poommyroboticcamera-netizen/ESC-FOC-Driver-V3.0/docs/assets/schematic-power-stage.png

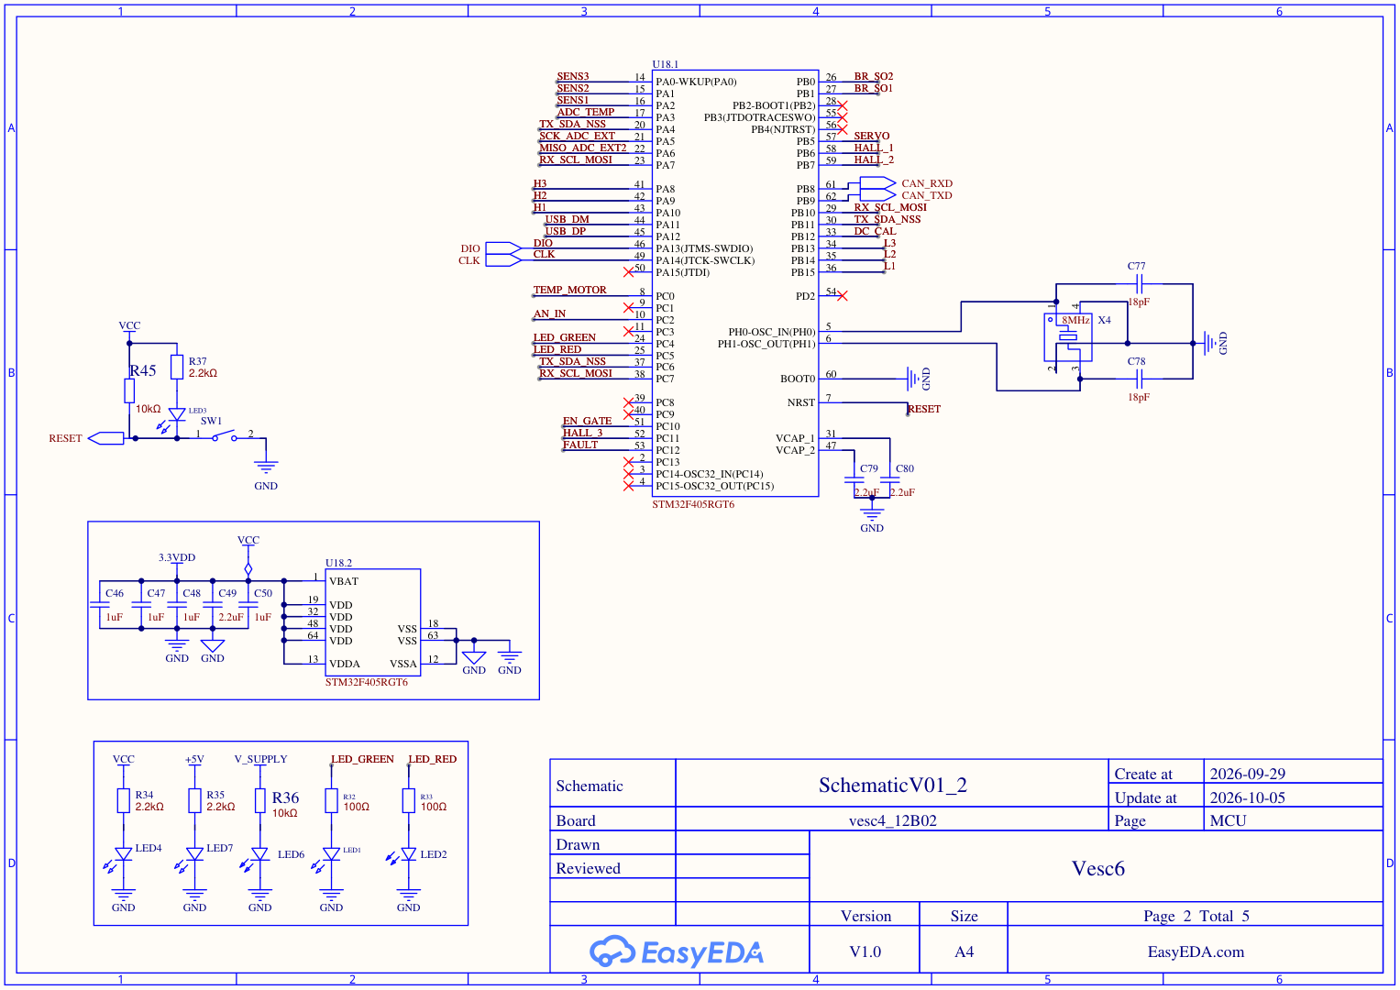
docs/assets/schematic-power-stage.png
