poommyroboticcamera-netizen/ESC-FOC-Driver-V3.0/hardware/mechanical/lm.STL

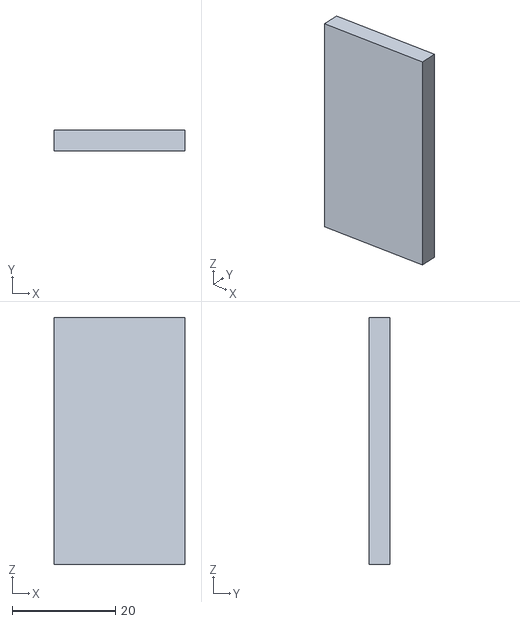
[picture p4: CAD file, 2026-10-19]
hardware/mechanical/lm.STL
25.4 x 4.00 x 47.9
