poommyroboticcamera-netizen/ESC-FOC-Driver-V3.0/hardware/mechanical/lcd.STL

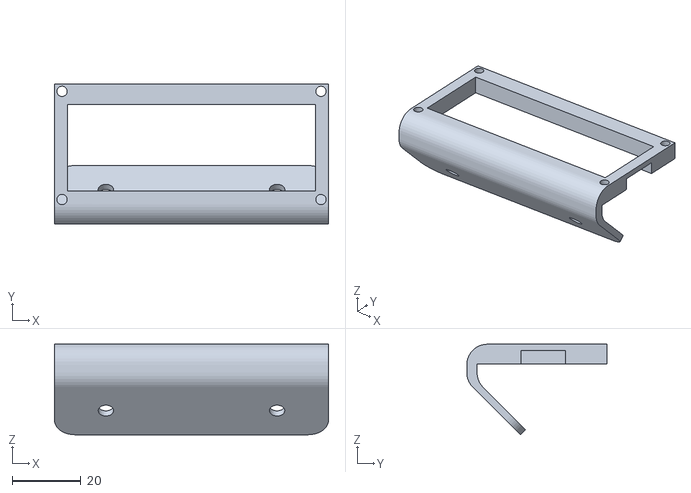
[picture p5: CAD file, 2026-10-19]
hardware/mechanical/lcd.STL
80.0 x 41.0 x 26.4
