poommyroboticcamera-netizen/ESC-FOC-Driver-V3.0/hardware/mechanical/grg.SLDPRT

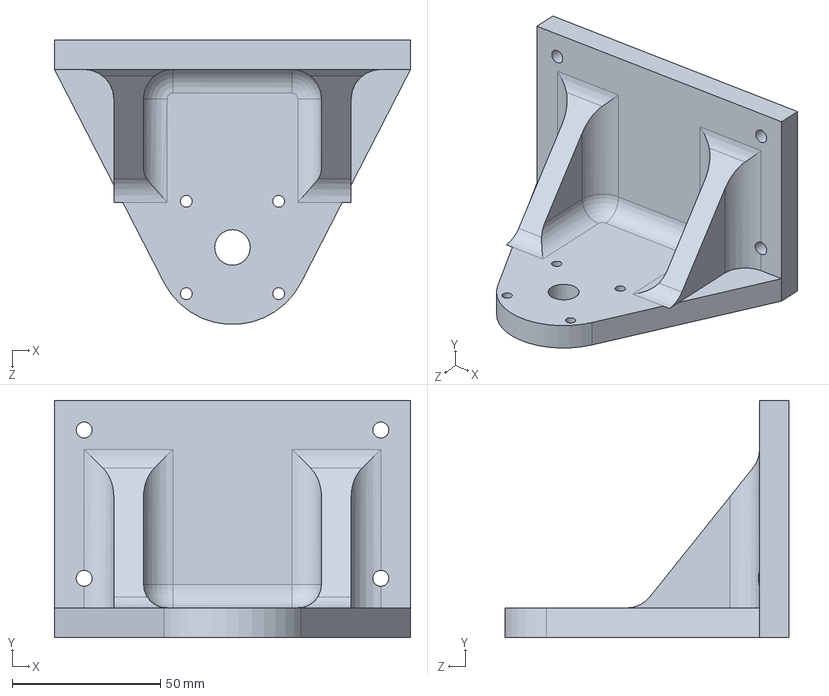
[picture p6: CAD file, 2026-10-19]
hardware/mechanical/grg.SLDPRT
120.0 x 80.0 x 95.9 mm
