poommyroboticcamera-netizen/ESC-FOC-Driver-V3.0/hardware/mechanical/encc.SLDPRT

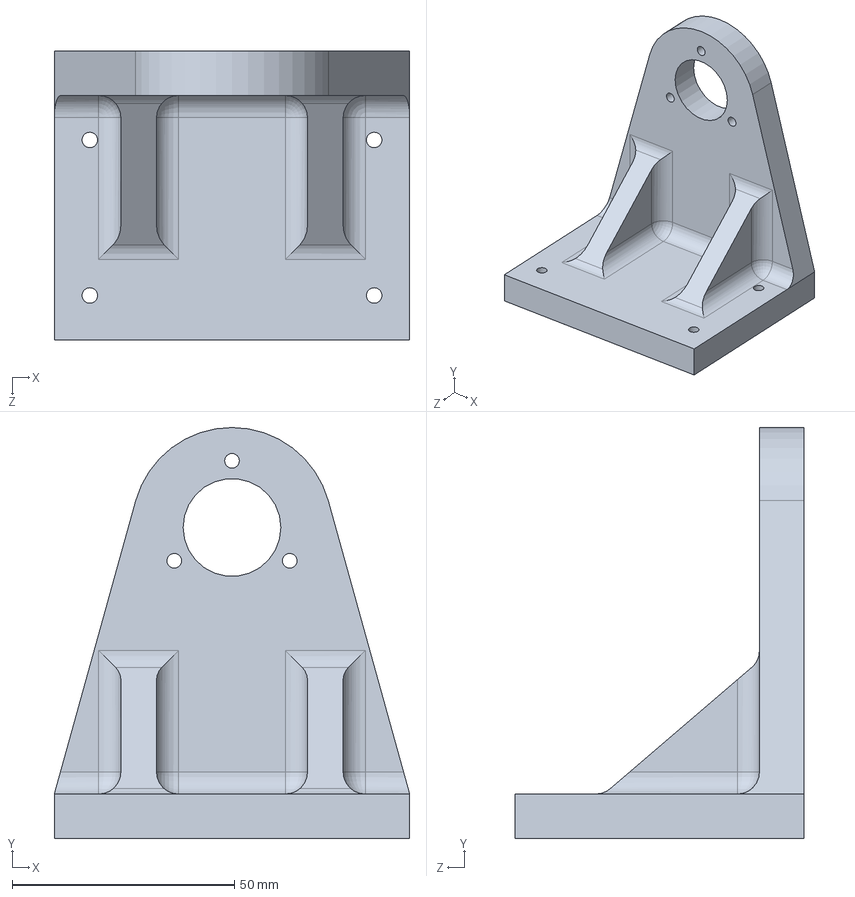
[picture p7: CAD file, 2026-10-19]
hardware/mechanical/encc.SLDPRT
80.0 x 92.5 x 65.0 mm
