poommyroboticcamera-netizen/ESC-FOC-Driver-V3.0/hardware/mechanical/Part1.STL

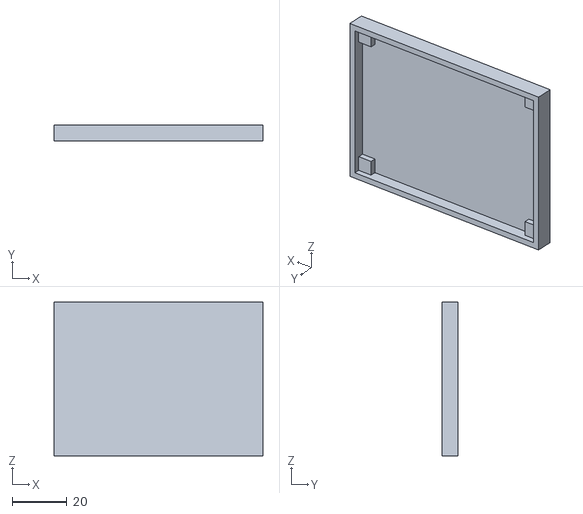
[picture p8: CAD file, 2026-10-19]
hardware/mechanical/Part1.STL
76.0 x 6.00 x 56.0
