poommyroboticcamera-netizen/ESC-FOC-Driver-V3.0/hardware/mechanical/stand.SLDPRT

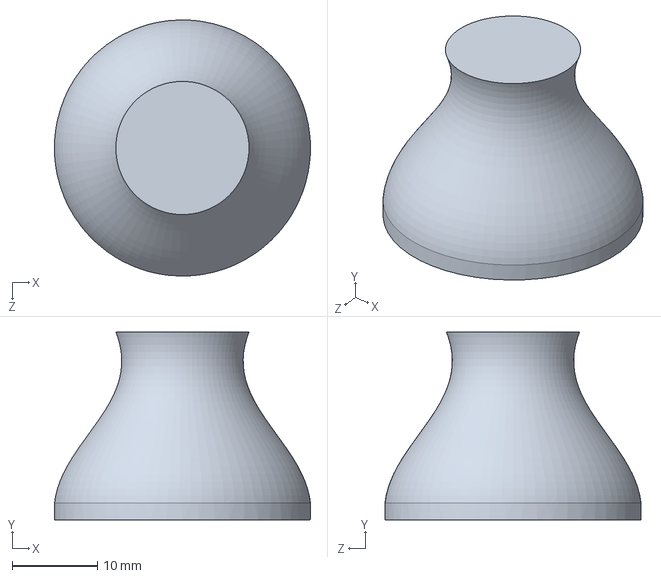
[picture p10: CAD file, 2026-10-19]
hardware/mechanical/stand.SLDPRT
30.0 x 22.0 x 30.0 mm
