poommyroboticcamera-netizen/ESC-FOC-Driver-V3.0/hardware/mechanical/Part41^caseV03.STL

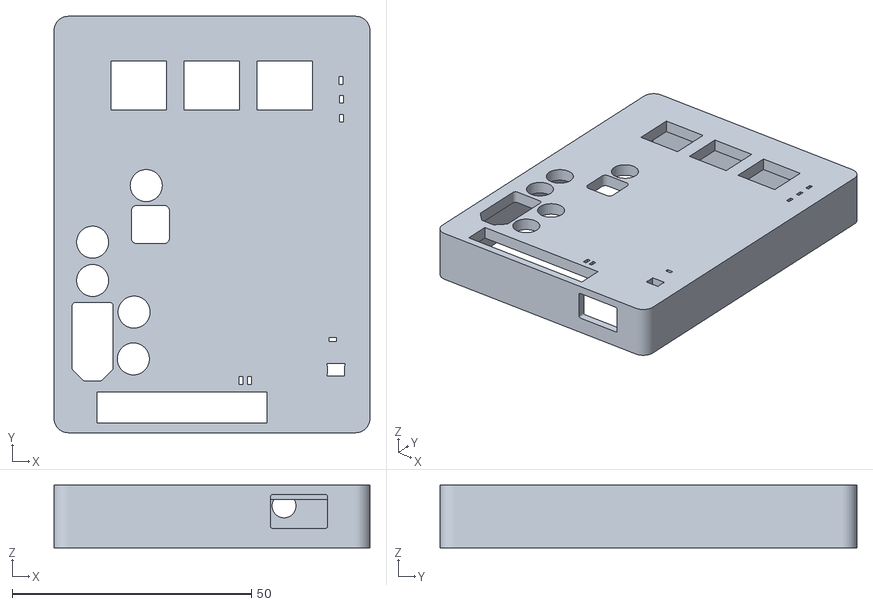
[picture p11: CAD file, 2026-10-19]
hardware/mechanical/Part41^caseV03.STL
66.0 x 87.0 x 13.1
