poommyroboticcamera-netizen/ESC-FOC-Driver-V3.0/hardware/mechanical/6384 Motor (1).step

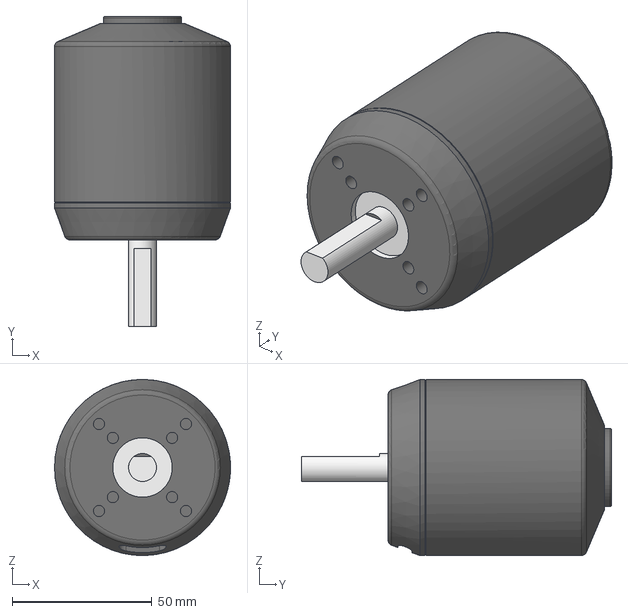
[picture p12: CAD file, 2026-10-19]
hardware/mechanical/6384 Motor (1).step
63.0 x 111.0 x 63.0 mm
