poommyroboticcamera-netizen/ESC-FOC-Driver-V3.0/hardware/mechanical/Electronic_rotary_encoder.STEP

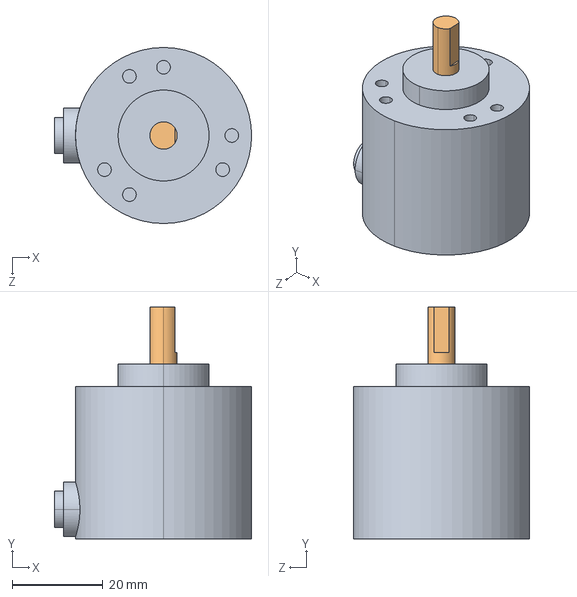
[picture p13: CAD file, 2026-10-19]
hardware/mechanical/Electronic_rotary_encoder.STEP
43.4 x 51.0 x 38.7 mm
electronic_rotary_encoder_001
electronic_rotary_encoder_002
