poommyroboticcamera-netizen/ESC-FOC-Driver-V3.0/hardware/mechanical/Part8^pro.SLDPRT

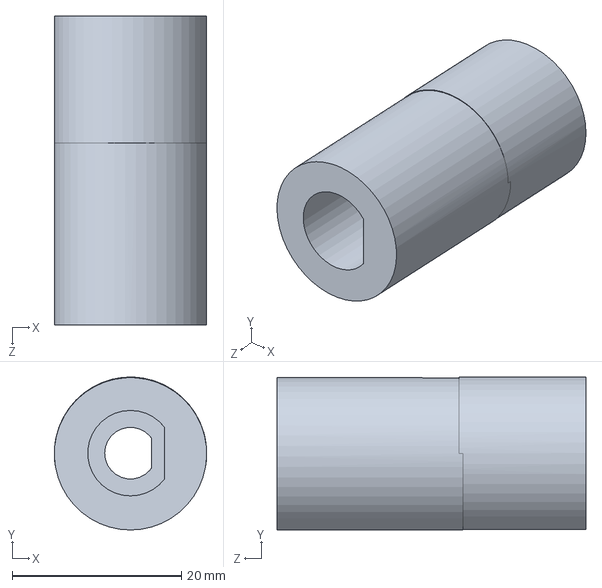
[picture p14: CAD file, 2026-10-19]
hardware/mechanical/Part8^pro.SLDPRT
18.0 x 18.1 x 36.5 mm
