poommyroboticcamera-netizen/ESC-FOC-Driver-V3.0/hardware/mechanical/plane.SLDPRT

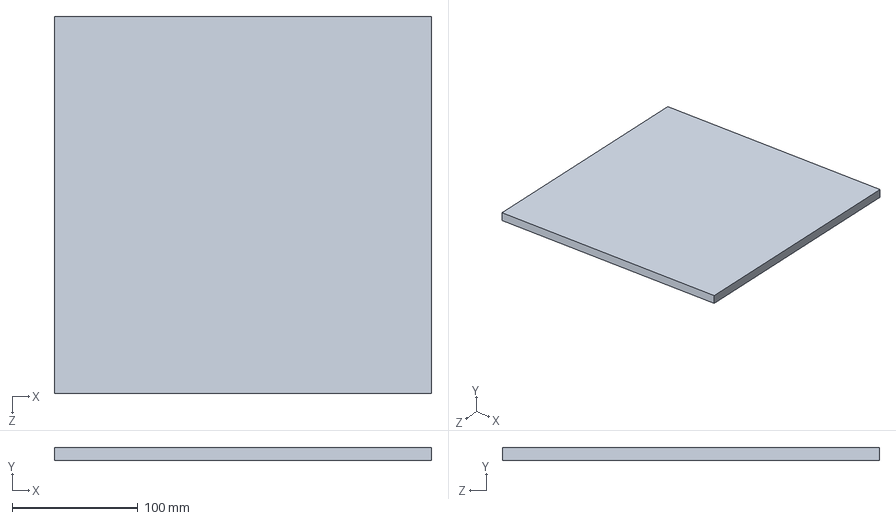
[picture p15: CAD file, 2026-10-19]
hardware/mechanical/plane.SLDPRT
300.0 x 10.0 x 300.0 mm
