poommyroboticcamera-netizen/ESC-FOC-Driver-V3.0/hardware/mechanical/emer.STL

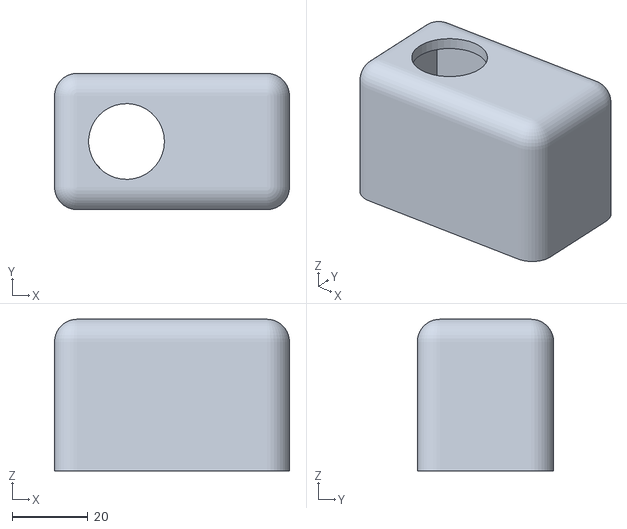
[picture p16: CAD file, 2026-10-19]
hardware/mechanical/emer.STL
62.0 x 36.0 x 40.0
