poommyroboticcamera-netizen/ESC-FOC-Driver-V3.0/hardware/mechanical/caseV03.SLDASM

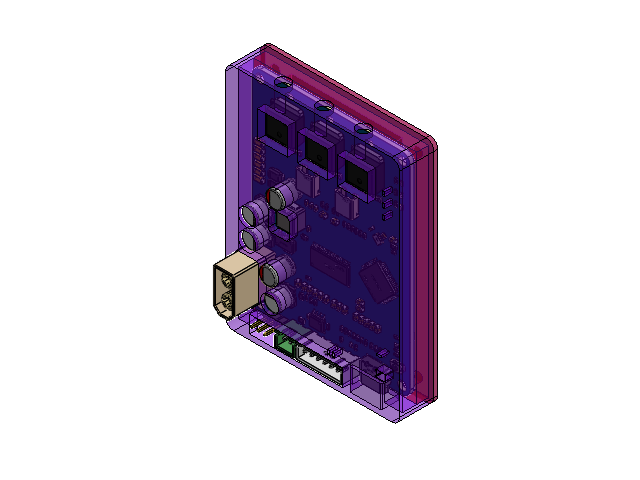
[picture p17: CAD file, 2026-10-19]
hardware/mechanical/caseV03.SLDASM
C0805~C0805_L2.0-W1.3-H1.3~hQ9a.step x 19
SMA_L4.2-W2.6-LS5.0-RD_1~SMA_L4.2-W2.6-LS5.0-RD_1~hQ9a.step x 2
SOD-123_L2.8-W1.8-LS3.7-RD~SOD-123_L2.8-W1.8-LS3.7-RD~hQ9a.step
R0603~R0603~hQ9a.step x 41
C1206~C1206_L3.2-W1.6-H1.3~hQ9a.step x 6
CAP-TH_BD6.3-P2.50-D0.5-FD_RYHT35V100UF6.3X8~CAP-TH_BD6.3-P2.50-D0.5-FD_RYHT35V100UF6.3X8~hQ9a.step x 2
IND-SMD_L7.0-W6.6_FXL0650~IND-SMD_L7.0-W6.6-H4.8_FXL0650~hQ9a.step
SOIC-8_L4.9-W3.9-P1.27-LS6.0-BL~SOIC-8_L4.9-W3.9-H1.7-LS6.0-P1.27~hQ9a.step
D2PAK-7_L10.6-W9.6-P1.27-LS15.9-BR~D2PAK-7_L10.6-W9.6-P1.27-LS15.9-BR~hQ9a.step x 6
C0603~C0603_L1.6-W0.8-H0.8~hQ9a.step x 7
CAP-SMD_BD6.3-L6.6-W6.6-LS7.3-FD~CAP-SMD_BD6.3-L6.6-W6.6-LS7.3-FD~hQ9a.step x 3
LED0603-RD_BLUE~LED0603-RD_BLUE~hQ9a.step
LED0603-RD_WHITE~LED0603-RD_WHITE~hQ9a.step
CONN-TH_2P-P2.50_JST_B2B-XH-A-M_C2858045~CONN-TH_2P-P2.50_JST_B2B-XH-A-M_C2858045~hQ9a.step
HDR-TH_3P-P2.54-V-M-1~HDR-M-2.54_1x3~hQ9a.step
RES-SMD_4P-L6.9-W6.6_WSLP2726L5000FEA~RES-SMD_4P-L6.9-W6.6_WSLP2726L5000FEA~hQ9a.step x 2
LED0603-RD_RED~LED0603-RD_RED~hQ9a.step
SW-SMD_L3.9-W3.0-P4.45~SW-SMD_L3.9-W2.9-H2.0-LS4.8~hQ9a.step
SMA_L4.3-W2.6-LS5.1-R-RD~SMA_L4.3-W2.6-LS5.1-R-RD~hQ9a.step
LED0603-RD_GREEN~LED0603-RD_GREEN~hQ9a.step
CRYSTAL-SMD_4P-L3.2-W2.5-BL~CRYSTAL-SMD_4P-L3.2-W2.5-BL~hQ9a.step
R0805~R0805_L2.0-W1.3-H0.6~hQ9a.step x 7
SOT-223_L6.5-W3.5-P2.30-LS7.0-BR~SOT-223-4P_L6.5-W3.5-H1.6-LS7.0-P2.30~hQ9a.step
CONN-TH_XH2.54-6P~CONN-TH_XH2.54-6P~hQ9a.step
USB-C-SMD_HYCW498-USBC16-735B~USB-C-SMD_HYCW498-USBC16-735B~hQ9a.step
LED0603-RD-YELLOW~LED0603-RD-YELLOW~hQ9a.step
HTSSOP-56_L14.0-W6.0-P0.50-LS8.0-BL~HTSSOP-56_L14.0-W6.1-H1.2-LS8.2-P0.50~hQ9a.step
CONN-TH_XT60PB-M~CONN-TH_XT60PB-M~hQ9a.step
LQFP-64_L10.0-W10.0-P0.50-LS12.0-BL~LQFP-64_L10.0-W10.0-H1.4-LS12.0-P0.50~hQ9a.step
Board~hQ9a.step
Part40^caseV03
Part41^caseV03
