poommyroboticcamera-netizen/ESC-FOC-Driver-V3.0/(list of files, cad)

Other CAD files:
hardware/mechanical/pro.SLDASM
hardware/mechanical/rdy.SLDPRT
hardware/mechanical/Part8^pro.STL
hardware/mechanical/encc.STL
hardware/mechanical/stand.STL
