poommyroboticcamera-netizen/ESC-FOC-Driver-V3.0/hardware/schematic/SCH_SchematicV01_2_2026-10-19.pdf

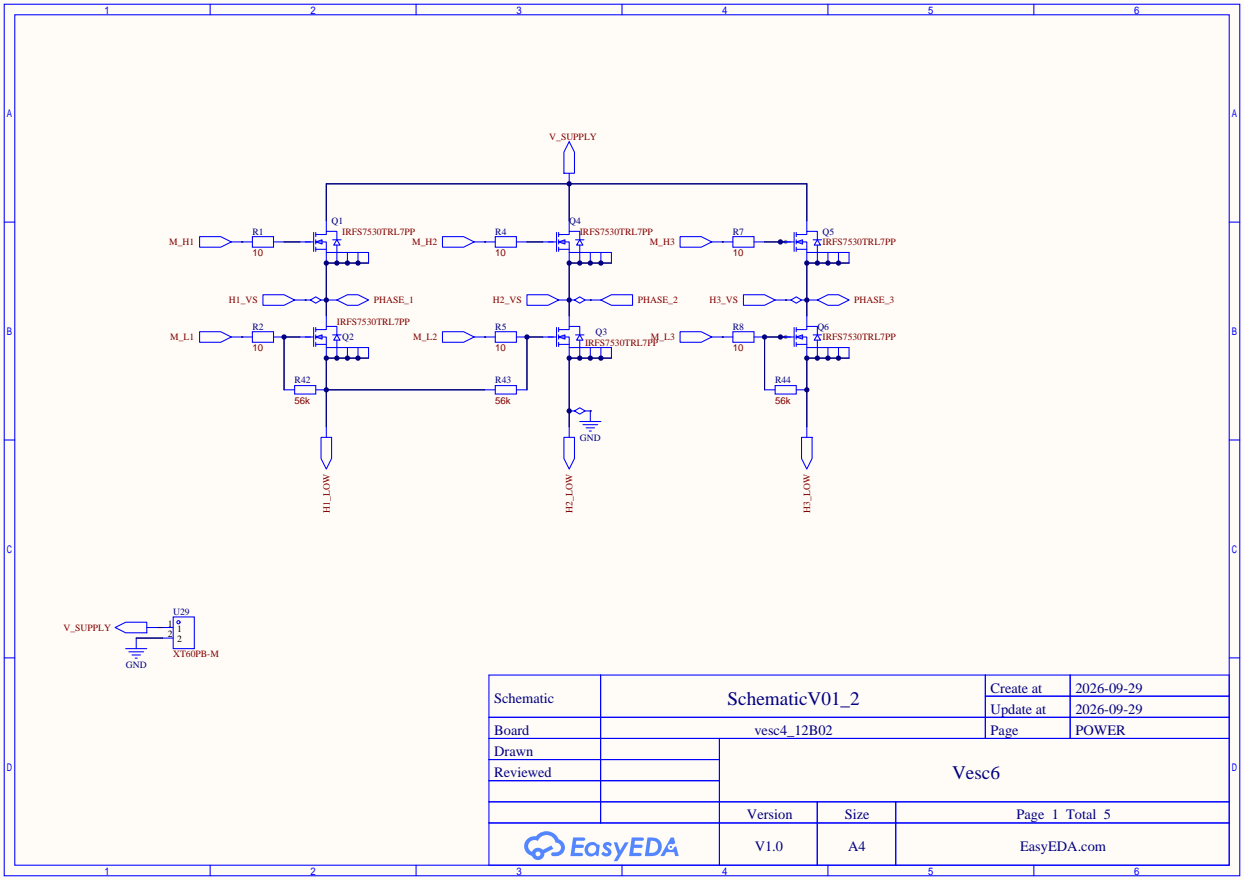
[picture p18: page 1]

Schematic | SchematicV01_2 | Create at | 2026-09-29

Update at | 2026-09-29

Board | vesc4_12B02 | Page | POWER
Drawn | | Vesc6
Reviewed

Version | Size | Page 1 Total 5

V1.0 | A4 | EasyEDA.com

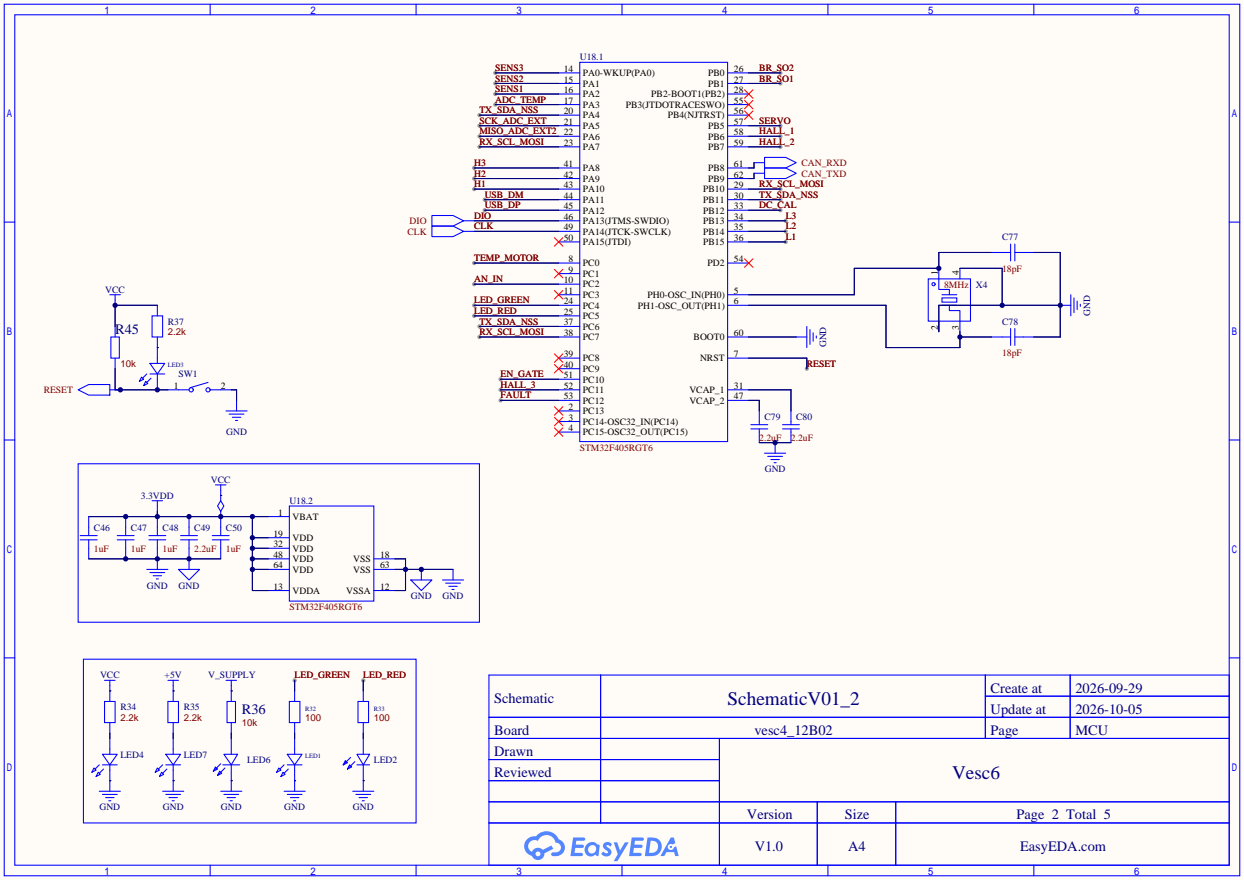
[picture p19: page 2]

Schematic | SchematicV01_2 | Create at | 2026-09-29

Update at | 2026-10-05

Board | vesc4_12B02 | Page | MCU
Drawn | | Vesc6
Reviewed

AGND 28 PVDD1 29 SP2 30 SN2 31 SP1 32 SN1 33 SL_C 34 GL_C 35 SH_C 36 GH_C 37 BST_C 38 SL_B 39 GL_B 40 SH_B 41 GH_B 42 BST_B 43 SL_A 44 GL_A 45 SH_A 46 GH_A 47 BST_A 48 BIAS 49 PH 50 PH 51 BST_BK 52 PVDD2 53 PVDD2 54 EN_BUCK 55 SS_TR 56

R16

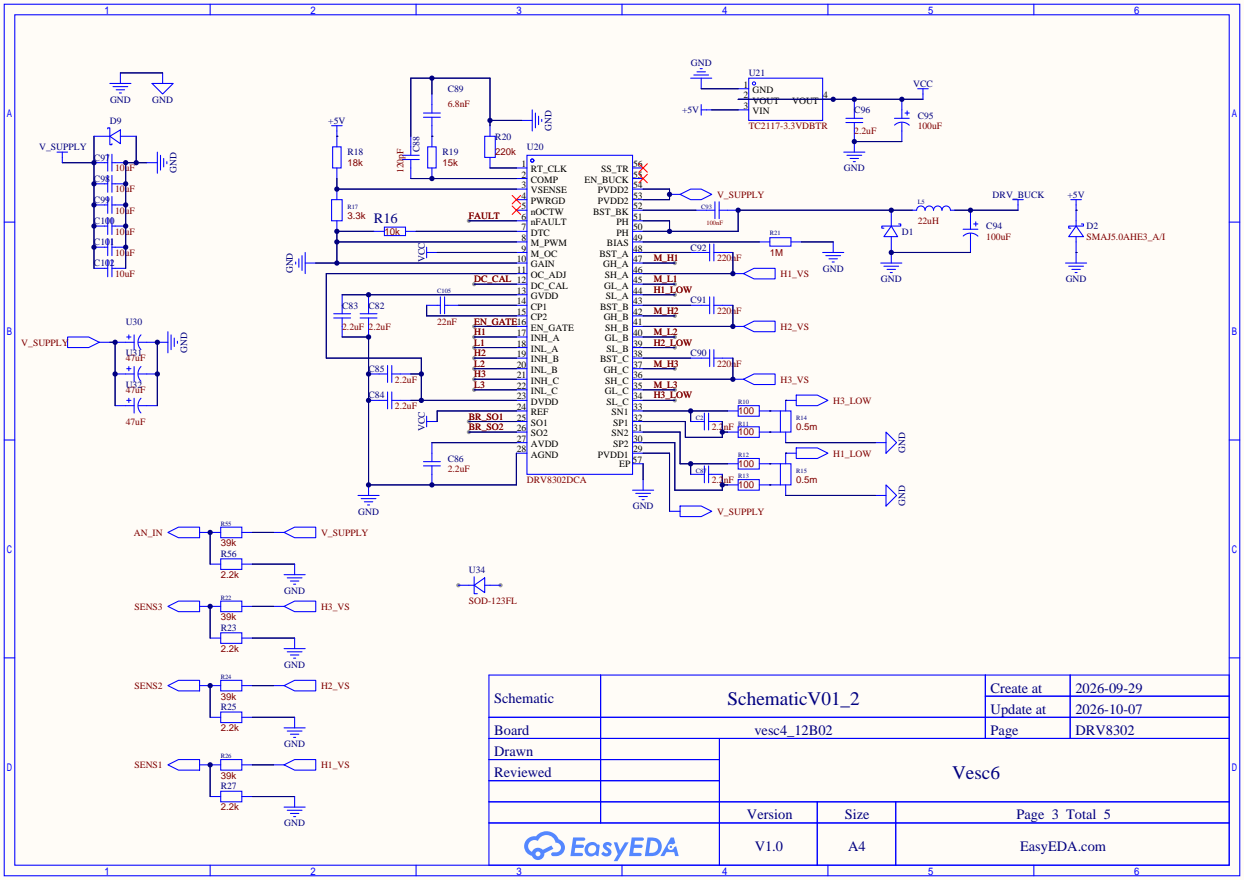
[picture p20: page 3]

Schematic | SchematicV01_2 | Create at | 2026-09-29

Update at | 2026-10-07

Board | vesc4_12B02 | Page | DRV8302
Drawn | | Vesc6
Reviewed

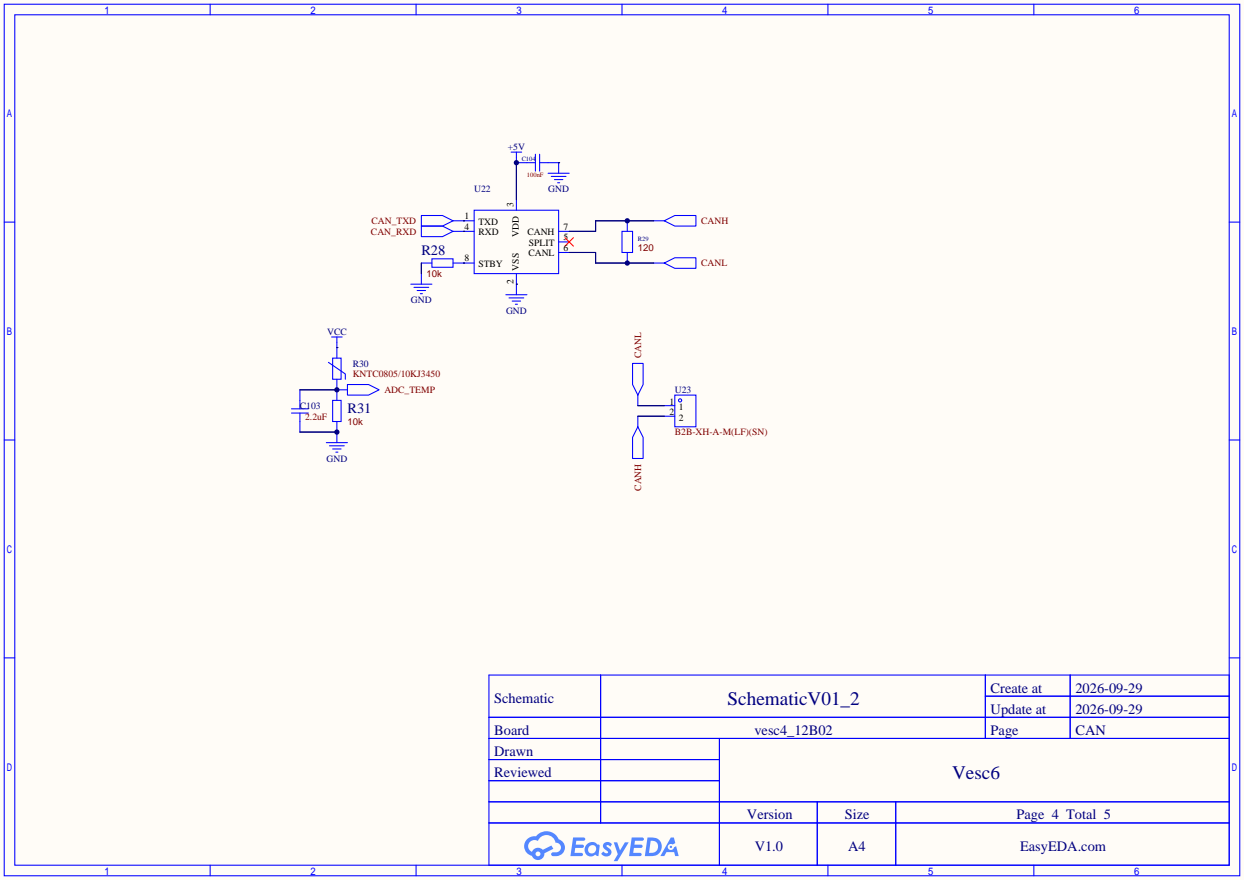
[picture p21: page 4]

Schematic | SchematicV01_2 | Create at | 2026-09-29

Update at | 2026-09-29

Board | vesc4_12B02 | Page | CAN
Drawn | | Vesc6
Reviewed

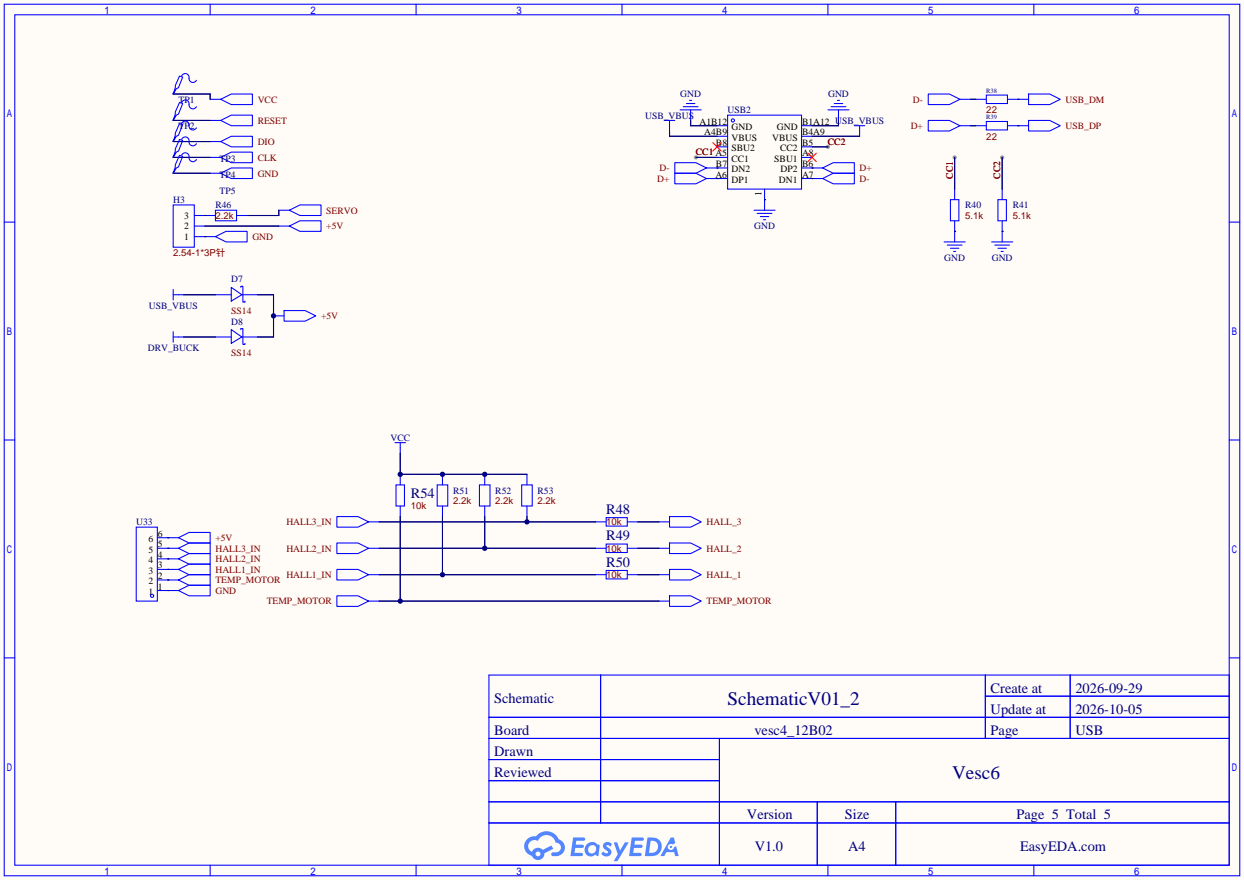
[picture p22: page 5]

Schematic | SchematicV01_2 | Create at | 2026-09-29

Update at | 2026-10-05

Board | vesc4_12B02 | Page | USB
Drawn | | Vesc6
Reviewed
